atown1993/GE-Kyber-Dual-Reader/docs/GE-Kyber-Dual-Reader-BOM.xlsx

GE Kyber Dual Reader — Bill of Materials
Affiliate tag (edit here, every link updates): |  | atown93-20
Blue = typed inputs (tag, ASIN, qty, price). Black = formulas. Yellow = fill in / verify. Prices = what was paid on the order date, not current.
# | Part | Role in the build | Qty needed | Pack size | Packs to buy | Unit price paid ($) | Cost for build ($) | ASIN | Affiliate link | Order date (price as-of) | Notes
1 | HiLetgo ESP32 OLED board (HW-724) | MCU + OLED display | 1 | 1 | 1 | $13.49 | $13.49 | B072HBW53G | amazon.com/dp/B072HBW53G | 2026-06-29 | Pin map is specific to this board (Wemos LOLIN32-OLED layout). Ordered as a 2-pack at $13.49 each.
2 | hiBCTR RDM6300 125 kHz RFID reader (HW-205) | Reader A and B, with stock coil | 2 | 1 | 2 | $8.27 | $16.54 | B0FDLFTGF9 | amazon.com/dp/B0FDLFTGF9 | 2026-08-05 | The two used in the build. Ships with the 46x32 mm coil.
3 | HiLetgo RDM6300 125 kHz RFID reader | Alternative reader (same module) | 0 | 1 | 0 | $8.29 | $0.00 | B00HGB9TOE | amazon.com/dp/B00HGB9TOE | 2025-09-10 | Interchangeable with the hiBCTR one; listed so builders have a second source.
4 | ALLECIN 2N7000 N-channel MOSFET, TO-92 | Ground switch per reader (TDM) | 2 | 100 | 1 | $7.99 | $7.99 | B0CBKHJQZF | amazon.com/dp/B0CBKHJQZF | 2026-01-07 | Any 2N7000 works.
5 | PANMILED 1/4 W resistor assortment, 140 values | Supplies 47 Ω, 220 Ω, 20 kΩ | 8 | 1400 | 1 | $16.50 | $16.50 | B0CTG793CV | amazon.com/dp/B0CTG793CV | 2025-09-22 | Need 4x 47 Ω, 2x 220 Ω, 2x 20 kΩ (plus 2x 10 kΩ if not using the next row). One kit covers everything.
6 | California JOS 10 kΩ 1/4 W resistors, 100 pcs | Divider top resistor | 2 | 100 | 1 | $4.97 | $4.97 | B0B4JFPHTW | amazon.com/dp/B0B4JFPHTW | 2025-07-04 | Optional — the assortment kit above also has 10 kΩ.
7 | EDGELEC 5 mm RGB LED, common anode, 100 pcs ("[24] Rgb Tri-color (Common Anode)" variant) | End indicator (one per end) | 2 | 100 | 1 | $8.99 | $8.99 | B077XD5T8P | amazon.com/dp/B077XD5T8P | 2026-09-03 (list price) | Longest leg = anode. Common-CATHODE variant of the same listing is B077XGF3YR — also works with COMMON_ANODE 0 and the common leg on GND. Reviewers note these are dim at 3.3 V, which is why G/B use 47 Ω.
8 | ELEGOO 400-point solderless breadboard, 6-pack | Mounts everything | 1 | 6 | 1 | $8.99 | $8.99 | B0CYPVMK9J | amazon.com/dp/B0CYPVMK9J | 2026-06-29 | 30 columns — the breadboard maps are drawn on exactly this board. Any larger board also works.
9 | ELEGOO Dupont jumper wires, 120 pcs M-M / M-F / F-F | Hook-up | 1 | 120 | 1 | $6.98 | $6.98 | B01EV70C78 | amazon.com/dp/B01EV70C78 | 2026-06-29 | Male-female for module headers, male-male for the board.
10 | SinLoon Dupont jumper wires M-F | Hook-up (alternative) | 0 | 1 | 0 | $8.99 | $0.00 | B08M3QLL3Q | amazon.com/dp/B08M3QLL3Q | 2026-08-09 | Second source.
 |  |  |  |  |  | Build cost (packs, as priced): | $84.45
 |  |  |  |  |  | Rows with qty 0 are alternates and add $0.
Sources: prices and ASINs from Matt's Amazon order history (2026-08-09 export) except the LED row (Amazon list price seen 2026-09-03). Prices are what was paid on the order date, not current.
