atown1993/GE-Kyber-Dual-Reader/docs/wiring-modules.png

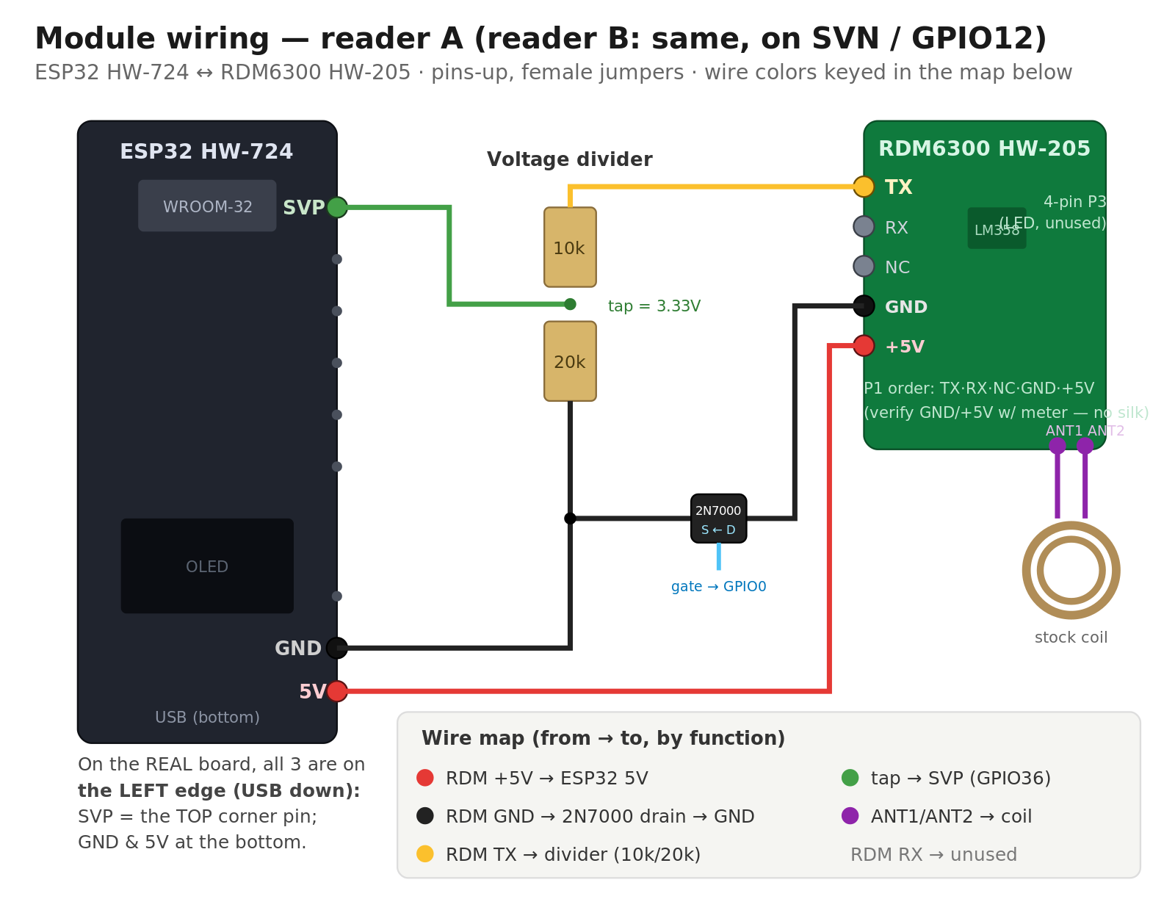
docs/wiring-modules.png
