atown1993/GE-Kyber-Dual-Reader/(commit log)

2026-09-04 Initial scaffold for GE-Kyber-Dual-Reader
    Created by atlas.py new on 2026-09-03: .gitattributes (LF pin, CLAUDE.md 16),
    .gitignore (house template, .commit-msgs/ excluded), README stub.
    Registered in Atlas as ge-kyber-dual-reader (program crystal-tech, Tier 3).
2026-09-04 Public release content: README, BUILD, EXPLAINER, LICENSE (MIT), ID map, drawings, three sketches on the final pin map
2026-09-04 pin map: drop private photo path reference
2026-09-04 BOM with affiliate links; breadboard maps re-laid to the 400-point (30-column) board; LED + breadboard ASINs
    [GE-Kyber-Dual-Reader-BOM.xlsx]
2026-09-04 reference: ruthsarian rfid_module_code.ino (with permission 2026-09-04); kyber_dual accepts 1-byte raw checksum clones + stale-frame reset; 0xC33=Black per his 2026 table; credits re-pointed
    [kyber_dual.ino, rfid_module_code.ino]
2026-09-05 kyber_dual: move charName() below struct Reader — Arduino 1.8 auto-prototypes land at the first function, which broke every Reader& signature
    [kyber_dual.ino]
2026-09-05 kyber_dual: print build date/time at boot so a stale flash is obvious
